Tanz801/TA-TA-PCB/README.md

This is a PCB based on TA-TA from the game Arknight endfields. Designed to be a simple digital pet. This was made for week 1 of hackclub half-life, and I choose to make TA-TA because the beginner project was a digital pet and I just thought TA-TA was a pretty cool and cute character.

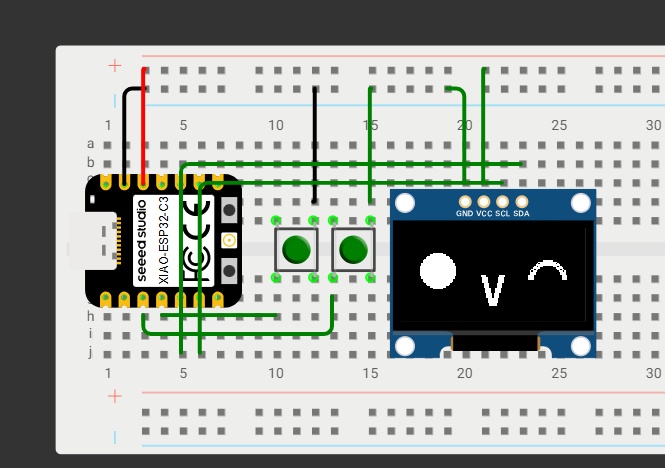
[picture p1: images/image.png]
Screen simulation


## Features

OLED screen for faces
Temperature sensor
Buzzer
Onboard battery charger
IMU to detect movement and orientation.

To be added:
Full organic feeling reactions to external stimuli

## Firmware flashing
The firmware can be flashed by downloading the firmware folder, opening as an esp-idf project, and flashing. However if you don't have the esp-idf framework installed or don't know how to use it, you can use python to flash the precompiled binaries through esptool

1. Install esptool``` pip install esptool ```
2. navigate to TA-TA-Firmware
3. run the following command
```python -m esptool --port PORT --baud 460800 write_flash @build/flashing_args```
replace PORT with the COM number of the esp if you're on windows, or the port on mac or linux.

## Assembling

Components just need to be soldered onto the pcb. The following sections can be done in any order:

### Microcontroller:
The Xiao ESP32 C3 is soldered onto the only component spot with surface mounts, the "pins" of the MCU should match the SMD pads on the PCB and the silkscreen

### Power button:
Solder the push button in the correct orientation based on the silkscreen at SW1, right side of the PCB

### Temperature sensor
Put the THT pins of the TMP36 through the holes next to U1 at the top left of the PCB, and bend it and solder it according to the silk screen.

A 0.1uF ceramic capacitor should be soldered at C1 directly underneath the TMP36

### IMU
If the MPU6050 did not come with header pins, solder headerpins onto the breakout board, make sure the spacers are at the bottom.
Solder the pins to J2 on the left of the microcontroller

### Buzzer
Solder the diode at D1, at the top of the PCB, make sure the direction of the diode (the white line) matches that of the silk screen

The transistor is soldered at the 3 THT holes at Q1, make sure the emitter is soldered to pin 1, the only hole among the 3 with a square pad.

A 1k resistor is soldered at R1, right below the transistor

Finally solder the buzzer at BZ1, with the anode at pin one (the hole with the square pad)

### Battery
the battery shouldn't be soldered but instead secured through any means such as double sided tape.
before connecting the battery to the jst connector, confirm the polarity of the battery, **look from the orientation where the buzzer would be at the top**. If when plugged in, the voltage source is on the right and gnd is on the left, nothing needs to be done, if its the reverse, scratch off the 2 preconnected solder jumpers at the bottom of the PCB then join the 2 previously disconnected jumpers with solder. Now the battery can be safely plugged in.

## BOM

|Item                                      |amount|cost (ea. CAD)|Link                                                                                                                                                                                                                                                                                                                                                                                                                                                                                                                                                                                                                                                                             |
|------------------------------------------|------|--------------|---------------------------------------------------------------------------------------------------------------------------------------------------------------------------------------------------------------------------------------------------------------------------------------------------------------------------------------------------------------------------------------------------------------------------------------------------------------------------------------------------------------------------------------------------------------------------------------------------------------------------------------------------------------------------------|
|XIAO ESP32 C3                             |1     |13.19         |https://www.aliexpress.com/item/1005008791937363.html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 |
|0.96 OLED                                 |1     |3.86          |https://www.aliexpress.com/item/1005006141235306.html                                                                                                                                                                                                                                                                                                                                                                                                                                                                                                                                                                                                                            |
|MPU6050                                   |1     |3.41          |https://www.aliexpress.com/item/1005008714169630.html                                                                                                                                                                                                                                                                                                                                                                                                                                                                                                                                                                                                                            |
|TMP32 Temperature sensor                  |1     |0.92          |https://www.aliexpress.com/item/4000082221164.html?mp=1                                                                                                                                                                                                                                                                                                                                                                                                                                                                                                                                                                                                                          |
|Passive buzzer                            |1     |0.43          |https://www.aliexpress.com/item/1005006135620280.html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  |
|2N2222 NPN transistor                     |1     |0.09          |https://www.aliexpress.com/item/1005005776372882.html                                                                                                                                                                                                                                                                                                                                                                                                                                                                                                                                                                                                                            |
|300mAh LiPo Battery 3.7V                  |1     |8.79          |https://www.aliexpress.com/item/1005008218024646.html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|
|1N4148 Diodes                             |1     |0.02          |https://www.aliexpress.com/item/4001126137167.html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                                                                                                                                                                                                                                                                                                                                           |
|1k resistor                               |1     |0.01          |https://www.aliexpress.com/item/1005006186890215.html?mp=1                                                                                                                                                                                                                                                                                                                                                                                                                                                                                                                                                                                                                       |
| 0.1 µF ceramic capacitor                 |1     |0.02          |https://www.aliexpress.com/item/1005011742959553.html                                                                                                                                                                                                                                                                                                                                                                                                                                                                                                                                                                                                                            |
|JST-PH housing                            |1     |0.03          |https://www.aliexpress.com/item/1005004955655144.html?mp=1                                                                                                                                                                                                                                                                                                                                                                                                                                                                                                                                                                                                                       |
|6x6x5MM 4PIN G90 Tactile Tact Push Button |1     |0.06          |https://www.aliexpress.com/item/32873398324.html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                                                                                                                                                                                                                                                                                                                                                                                                                                                                                                                                          |
|PCB                                       |1     |2.56          |https://cart.jlcpcb.com/quote?rand=0.883814583740498                                                                                                                                                                                                                                                                                                                                                                                                                                                                                                                                                                                                                             |
|Total                                     |      |33.39         |                     

## PCB Wiring and Schematics

![PCB wiring](images/PCB-Wiring.png)
![PCB schematics](images/PCB-Schematics.png)
![PCB 3D View](images/3D-view.png)
