Tanz801/TA-TA-PCB/images/3D-view.png

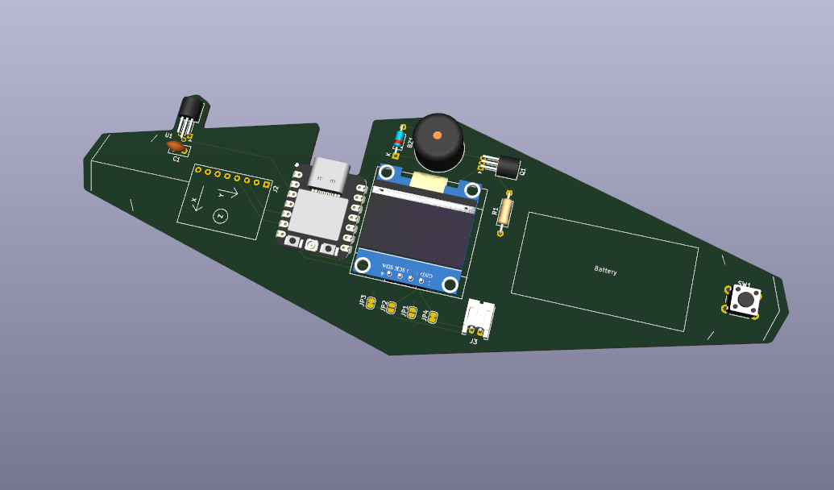
images/3D-view.png
