Tanz801/TA-TA-PCB/images/PCB-Schematics.png

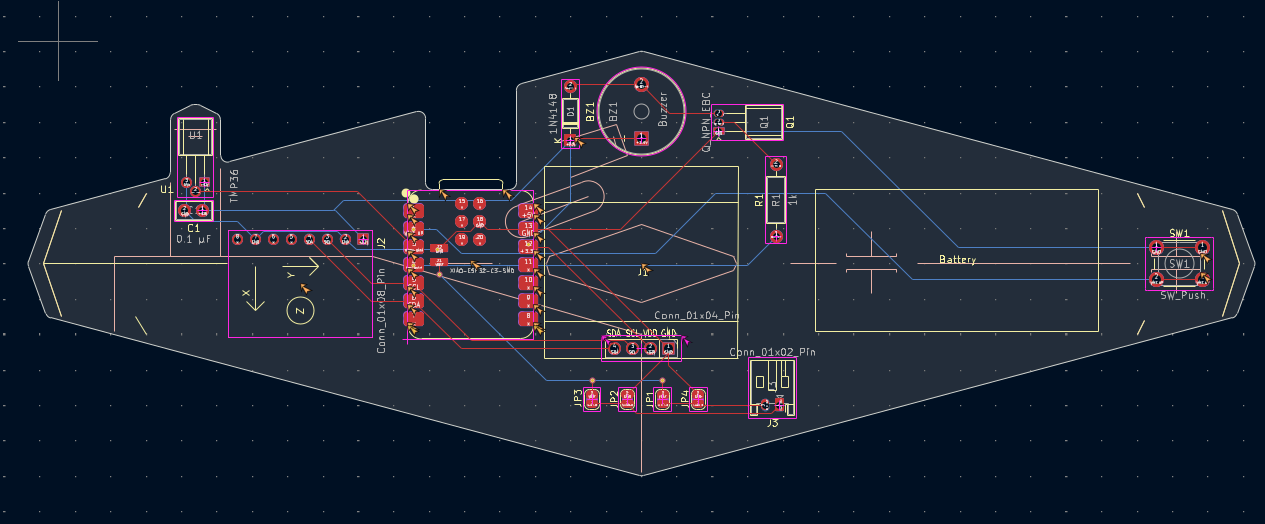
images/PCB-Schematics.png
