Tanz801/TA-TA-PCB/PCB/PCB.step

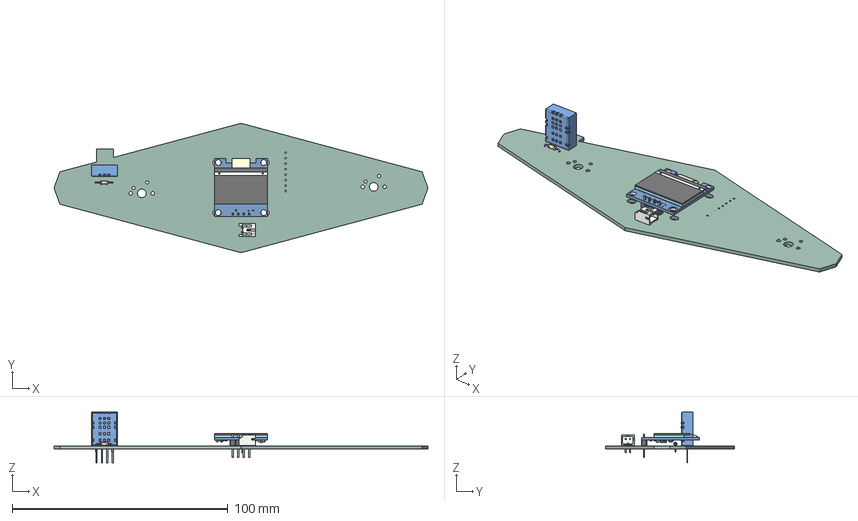
[picture p4: CAD file, 2026-10-12]
PCB/PCB.step
173.4 x 60.0 x 23.5 mm
R_Axial_DIN0204_L36mm_D16mm_P762mm_Horizontal
4x1 male header pins v2
Aosong_DHT11_5.5x12.0_P2.54mm
JST_S2B_PH_K
TA-TA_PCB
