Tanz801/TA-TA-PCB/PCB/TA-TA.kicad_pcb

## KiCad design PCB/TA-TA.kicad_pcb (2026-11-12)

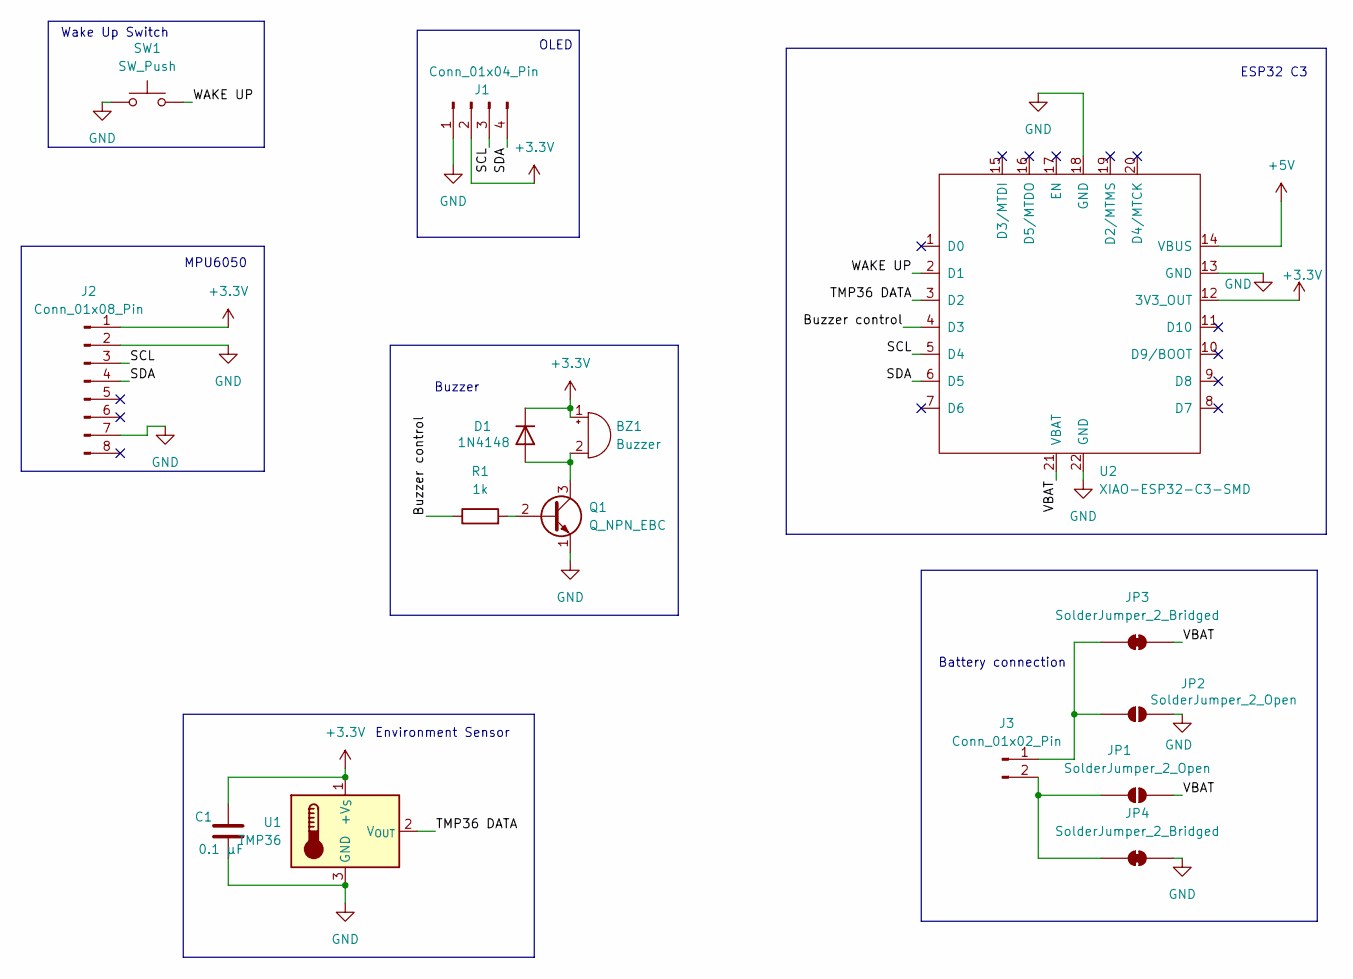
[picture p5: schematic TA-TA.kicad_sch]

Parts:
BZ1: Buzzer; Buzzer_12x9.5RM7.6
C1: 0.1 µF; C_Disc_D5.0mm_W2.5mm_P2.50mm
D1: 1N4148; D_DO-35_SOD27_P7.62mm_Horizontal
J1: Conn_01x04_Pin; Display_128x64_096_I2C
J2: Conn_01x08_Pin; MPU6050_Module
J3: Conn_01x02_Pin; JST_PH_S2B-PH-K_1x02_P2.00mm_Horizontal
JP1, JP2: SolderJumper_2_Open; SolderJumper-2_P1.3mm_Open_RoundedPad1.0x1.5mm
JP3, JP4: SolderJumper_2_Bridged; SolderJumper-2_P1.3mm_Bridged_RoundedPad1.0x1.5mm
Q1: Q_NPN_EBC; TO-92_Inline_W4.0mm_Horizontal_FlatSideDown
R1: 1k; R_Axial_DIN0207_L6.3mm_D2.5mm_P10.16mm_Horizontal
SW1: SW_Push; SW_PUSH_6mm
U1: TMP36; TO-92_W4.0mm_StaggerEven_Horizontal_FlatSideDown
U2: XIAO-ESP32-C3-SMD

Connections:
+3.3V: BZ1.1 (+), C1.1, D1.1 (K), J1.2, J2.1, U1.1 (+V_{S}), U2.12 (3V3_OUT)
+5V: U2.14 (VBUS)
/Buzzer control: R1.1, U2.4 (D3)
/SCL: J1.3, J2.3, U2.5 (D4)
/SDA: J1.4, J2.4, U2.6 (D5)
/TMP36 DATA: U1.2 (V_{OUT}), U2.3 (D2)
/VBAT: JP1.2 (B), JP3.2 (B), U2.21 (VBAT)
/WAKE UP: SW1.2, U2.2 (D1)
GND: C1.2, J1.1, J2.2, J2.7, JP2.2 (B), JP4.2 (B), Q1.1 (E), SW1.1, U1.3 (GND), U2.13 (GND), U2.18 (GND), U2.22 (GND)
unnamed: BZ1.2 (-), D1.2 (A), Q1.3 (C)
unnamed: J3.1, JP2.1 (A), JP3.1 (A)
unnamed: J3.2, JP1.1 (A), JP4.1 (A)
unnamed: Q1.2 (B), R1.2

Notes on the sheet:
Environment Sensor
ESP32 C3
OLED
Battery connection
Wake Up Switch
Buzzer
MPU6050

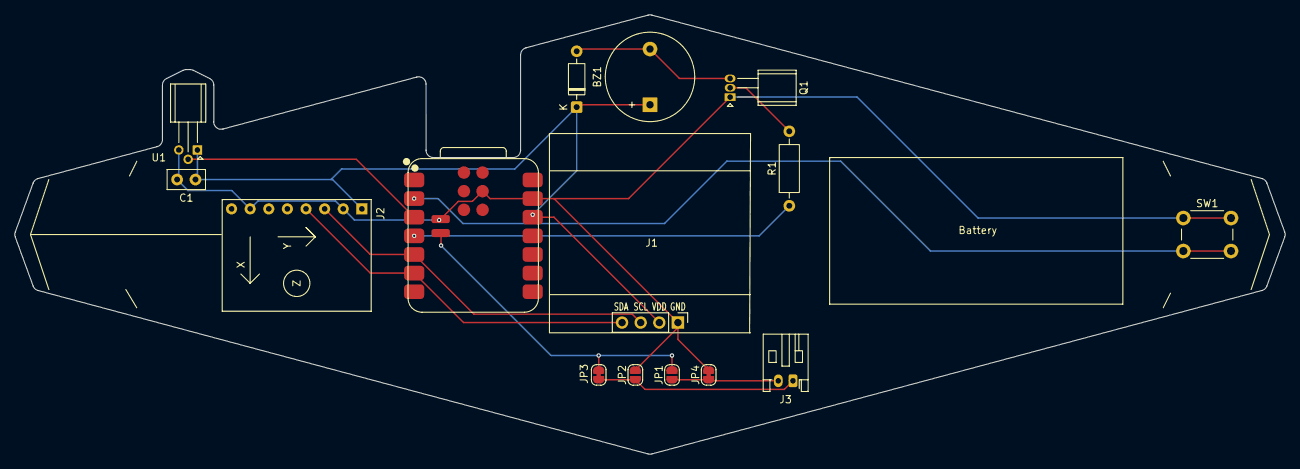
[picture p6: board TA-TA.kicad_pcb from above]

Board: 2 copper layers, 173.3 x 59.9 mm, 15 parts (0 on the bottom side), 12 nets.
