Tanz801/TA-TA-PCB/images/PCB-Wiring.png

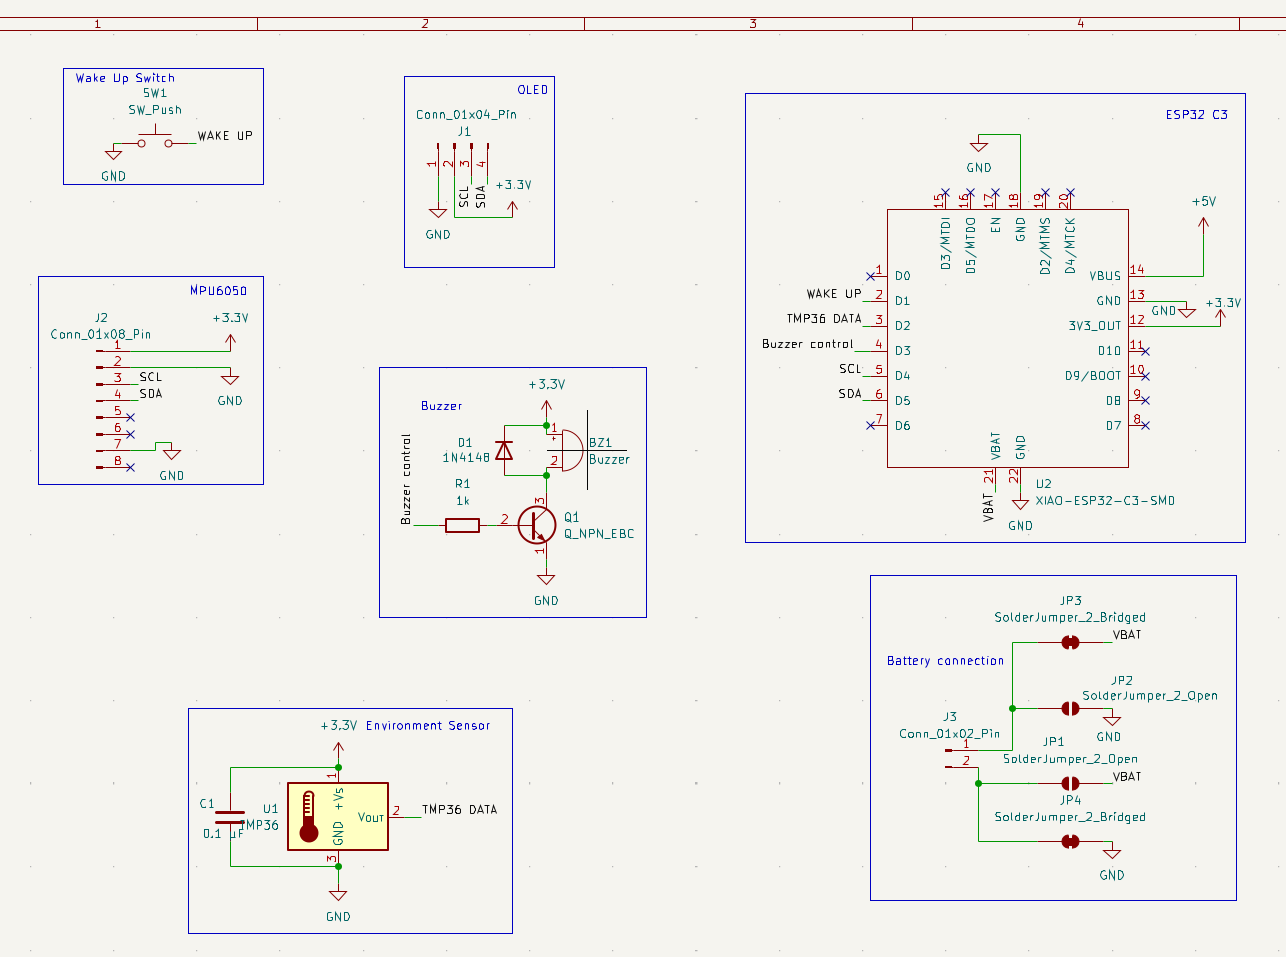
images/PCB-Wiring.png
