Tanz801/TA-TA-PCB/(commit log)

2026-10-21 Added BOM
    [BOM.csv]
2026-11-10 usb-c on edge now :(
    [TA-TA-B_Cu.gbr, TA-TA-B_Mask.gbr, TA-TA-B_Paste.gbr, TA-TA-B_Silkscreen.gbr, TA-TA-Edge_Cuts.gbr, TA-TA-F_Cu.gbr, TA-TA-F_Mask.gbr, TA-TA-F_Paste.gbr]
2026-11-12 added assmebling to read me, fixed pcb
    [TA-TA-B_Cu.gbr, TA-TA-B_Mask.gbr, TA-TA-B_Paste.gbr, TA-TA-B_Silkscreen.gbr, TA-TA-Edge_Cuts.gbr, TA-TA-F_Cu.gbr, TA-TA-F_Mask.gbr, TA-TA-F_Paste.gbr]
